ValdemarOrn/KickBrain/Releases/readme.txt

This is the release directory. Here you can find all officially compiled and released versions of the KickBrain PC software.

PIC code, Arduino code and schematics can be found in other directories in this Git repository.
