ValdemarOrn/KickBrain/Schematic/PCB Layout.png

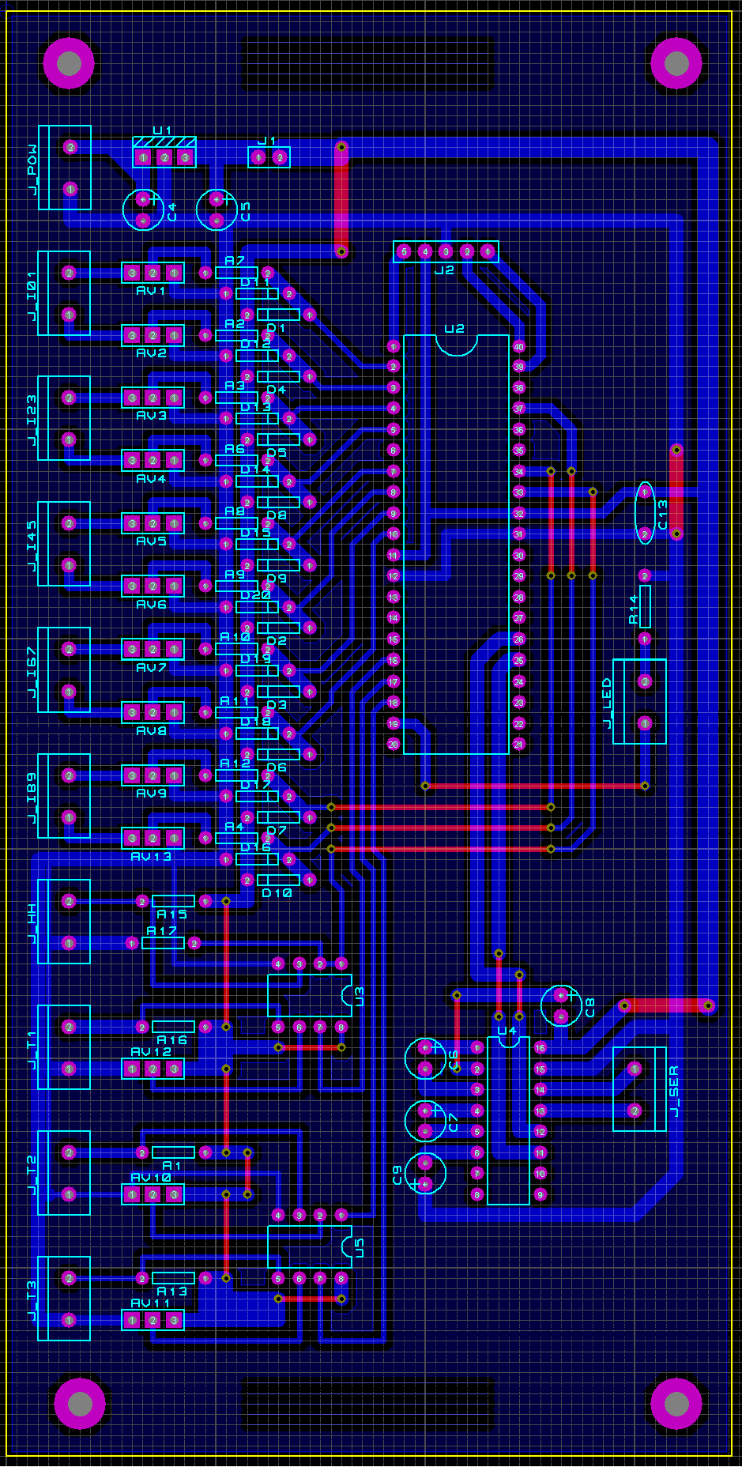
Schematic/PCB Layout.png
