ValdemarOrn/KickBrain/Schematic/PCB Layout.pdf

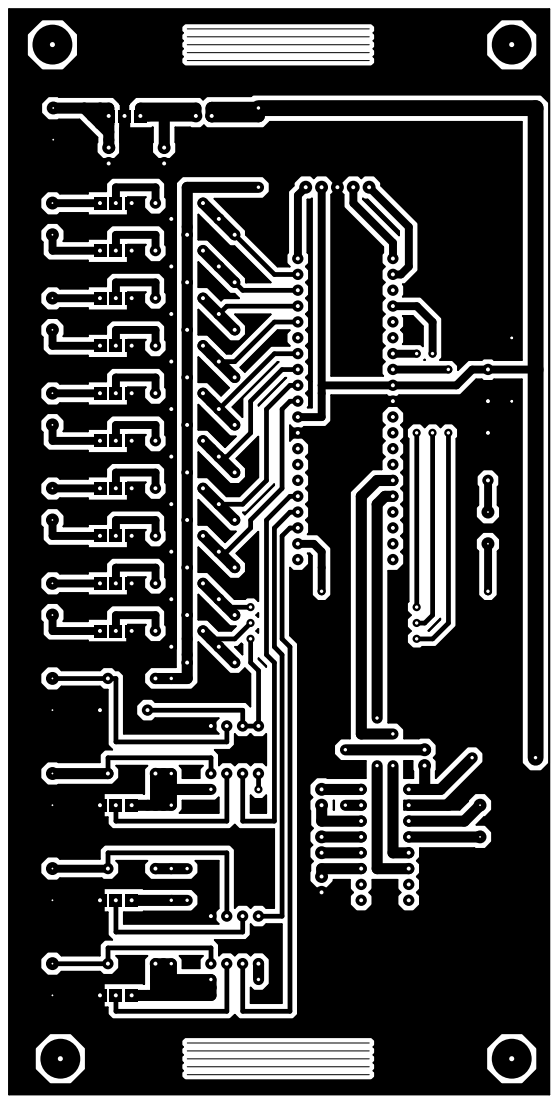
[picture p6: page 1]
