ValdemarOrn/KickBrain/Schematic/Schematic.pdf

J1

U3:A

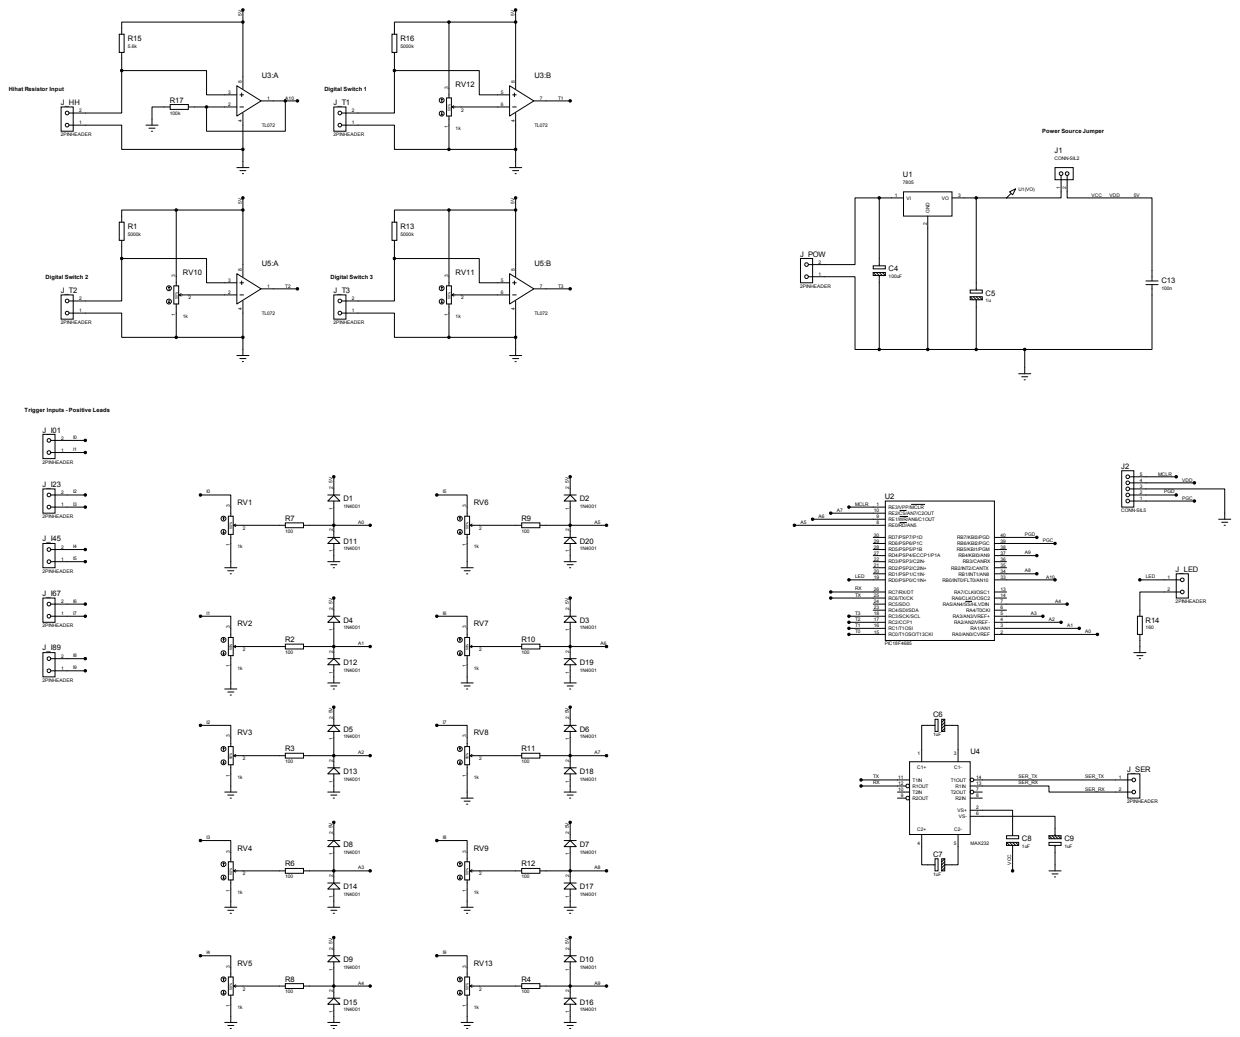
[picture p7: page 1]

Trigger Inputs - Positive Leads
