ValdemarOrn/KickBrain/Schematic/Alpha Board/Power Board.asc

C1: cap; 1000µ
C2: cap; 1000µ
C3: cap; 4700µ
D1: diode; 1N4148
D2: diode; 1N4148
D3: diode; 1N4148
D4: diode; 1N4148
R1: res; 100
R2: res; 10
R3: res; 10
R4: res; 100
R5: res; 100k
V1: voltage; 5
V2: voltage; SINE(0 5 500)
V3: voltage; 0.0000001
Named nets: h, l, b, 0
.tran 0 0.22 0.2 0.00001
