ValdemarOrn/KickBrain/(list of files, drawings)

Other design files:
Schematic/Alpha Board/Board_sim.DSN
Schematic/Alpha Board/Power Board Hihat.DSN
Schematic/Alpha Board/Power Board Hihat.LYT
Schematic/Alpha Board/Power Board.DSN
Schematic/Alpha Board/Power Board.LYT
Schematic/Power Board.DSN
Schematic/Power Board.LYT
