ValdemarOrn/KickBrain/(commit log)

2012-05-01 Loads of changes. Switched arduino to non-blocking serial output
2012-05-01 Added velocity Control and propertyGrid
2012-06-20 added pic code and schematics
    [Board_sim.DSN, Kickbrain.cfg, Power Board Digital.DSN, Power Board Digital.LYT, Power Board Digital.SDF, Power Board Hihat.DSN, Power Board Hihat.LYT, Power Board Hihat.SDF]
2012-06-28 Improvements on KickBrain software. Completed Output operations
    [Power Board Hihat.SDF]
2012-07-20 changed midi library to NAudio. Fixed schematics. New PIC code. Version 1.0
    [Board_sim.DSN, Power Board Digital.DSN, Power Board Digital.LYT, Power Board Digital.SDF, Power Board Hihat.DSN, Power Board Hihat.LYT, Power Board Hihat.SDF]
2012-07-24 Removed garbage. Added about window. Added ability to open and associate files with the executable
    [Board_sim.DSN, Power Board Hihat.DSN, Power Board Hihat.LYT, Power Board Hihat.SDF, Power Board.DSN, Power Board.LYT, Power Board.SDF]
